picli3/firefly/doc/2026-10-24_06-07.jpg

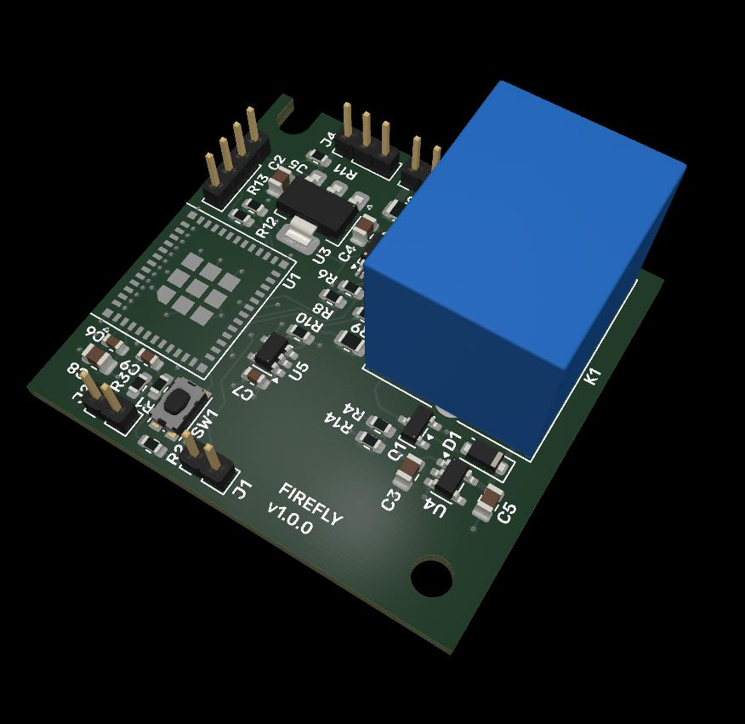
doc/2026-10-24_06-07.jpg
