picli3/firefly/emergency-light-pcb/docs/2026-11-10_10-52.jpg

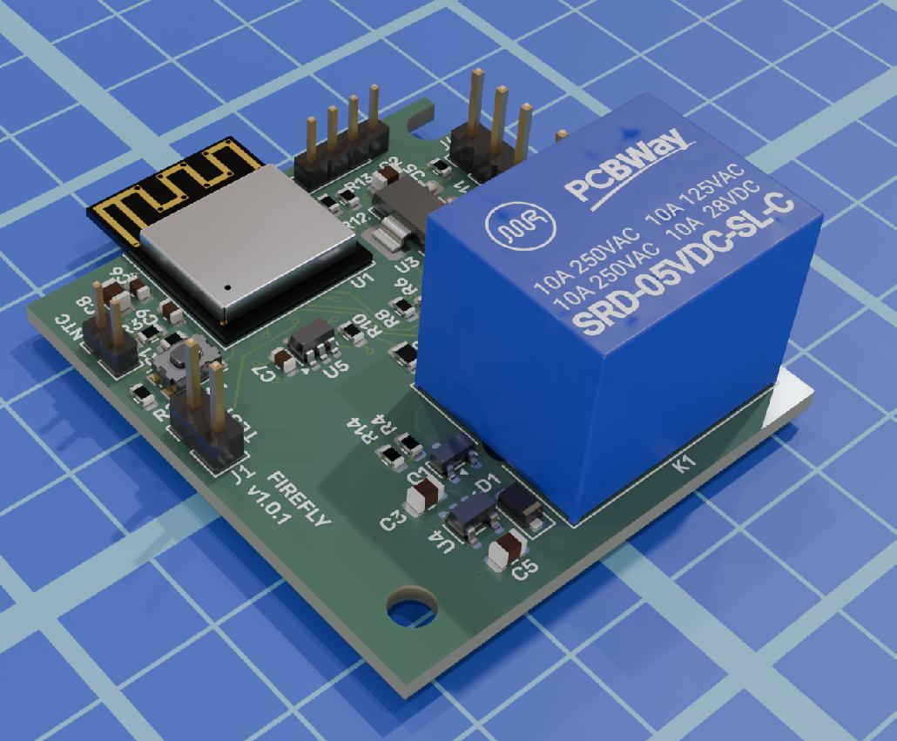
emergency-light-pcb/docs/2026-11-10_10-52.jpg
