picli3/firefly/emergency-light-pcb/docs/2026-11-10_10-54.jpg

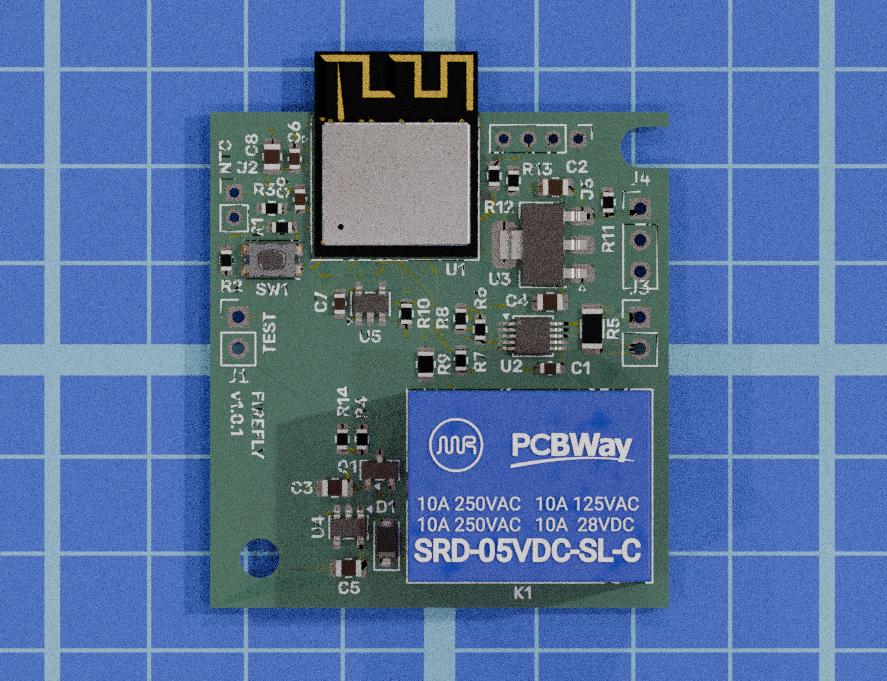
emergency-light-pcb/docs/2026-11-10_10-54.jpg
