picli3/firefly/emergency-light-pcb/docs/2026-11-10_11-06.jpg

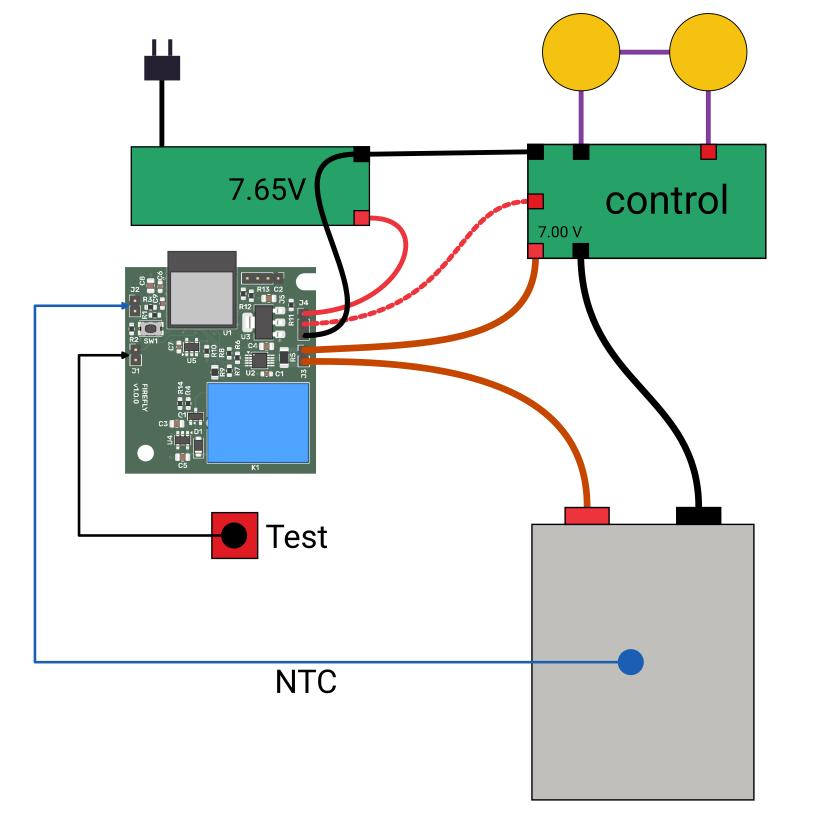
emergency-light-pcb/docs/2026-11-10_11-06.jpg
