picli3/firefly/emergency-light-pcb/docs/photo_2026-11-10_10-07-28.jpg

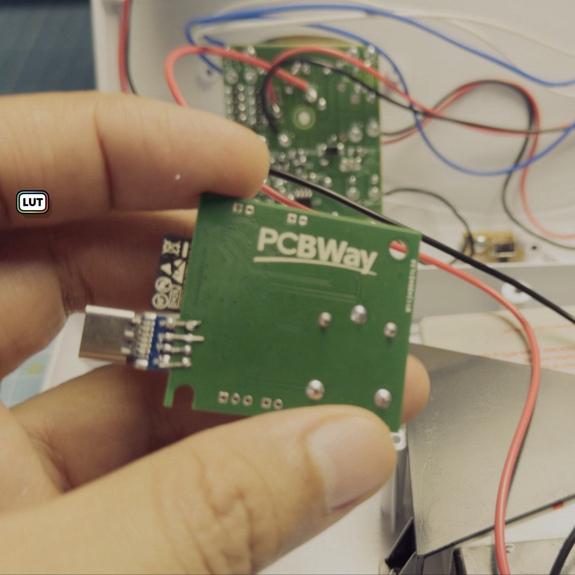
emergency-light-pcb/docs/photo_2026-11-10_10-07-28.jpg
