picli3/firefly/emergency-light-pcb/docs/RELE.png

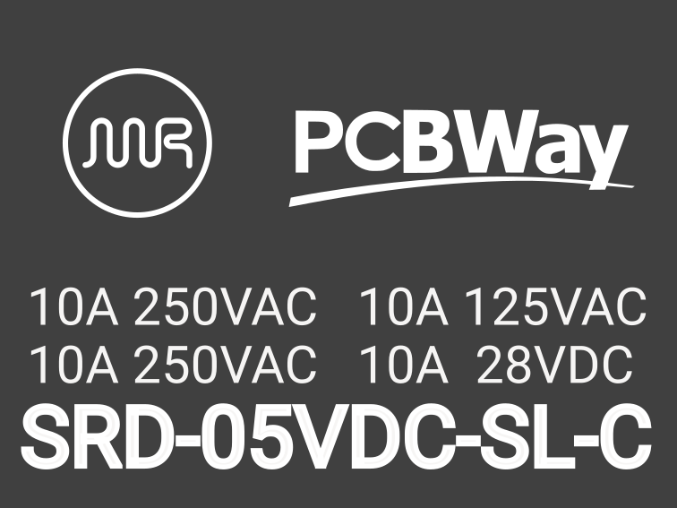
emergency-light-pcb/docs/RELE.png
