picli3/firefly/firmware/h2-emergency-light/img/esp32-h2-supermini.jpg

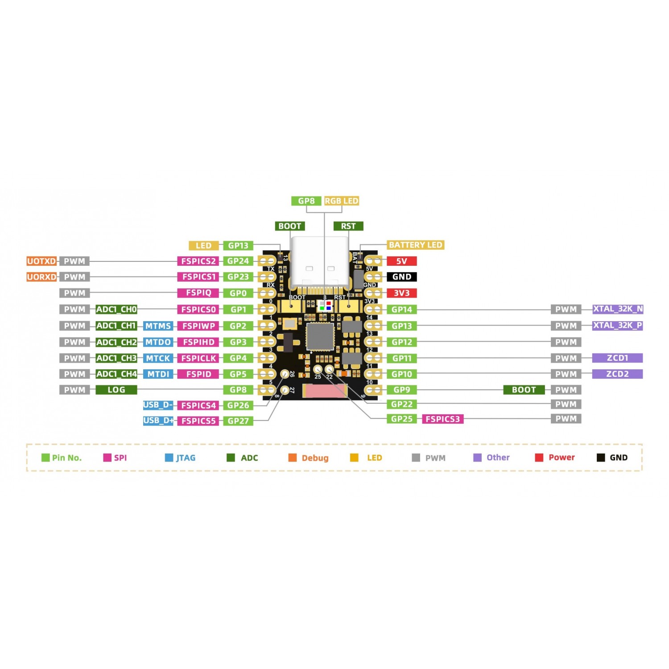
firmware/h2-emergency-light/img/esp32-h2-supermini.jpg
