picli3/firefly/mechanical/emergency-light-pcb.FCStd

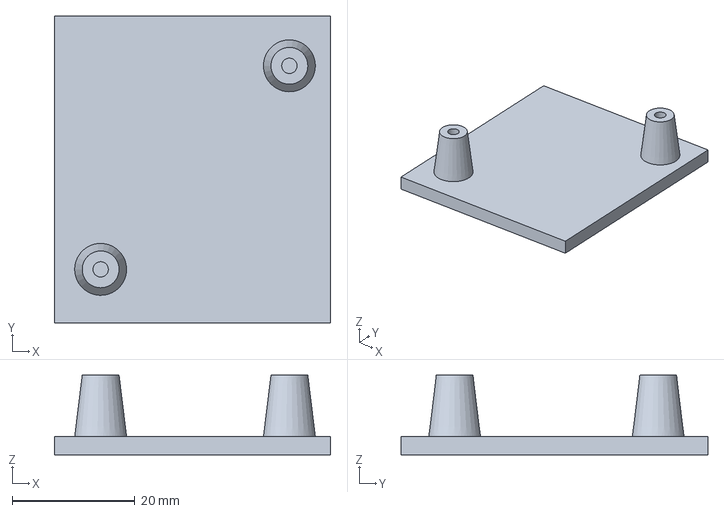
[picture p13: CAD file, 2026-11-10]
mechanical/emergency-light-pcb.FCStd
45.0 x 50.0 x 13.0 mm
