picli3/firefly/emergency-light-pcb/emergency-light-pcb.kicad_pcb

## KiCad design emergency-light-pcb/emergency-light-pcb.kicad_pcb (2026-11-10)

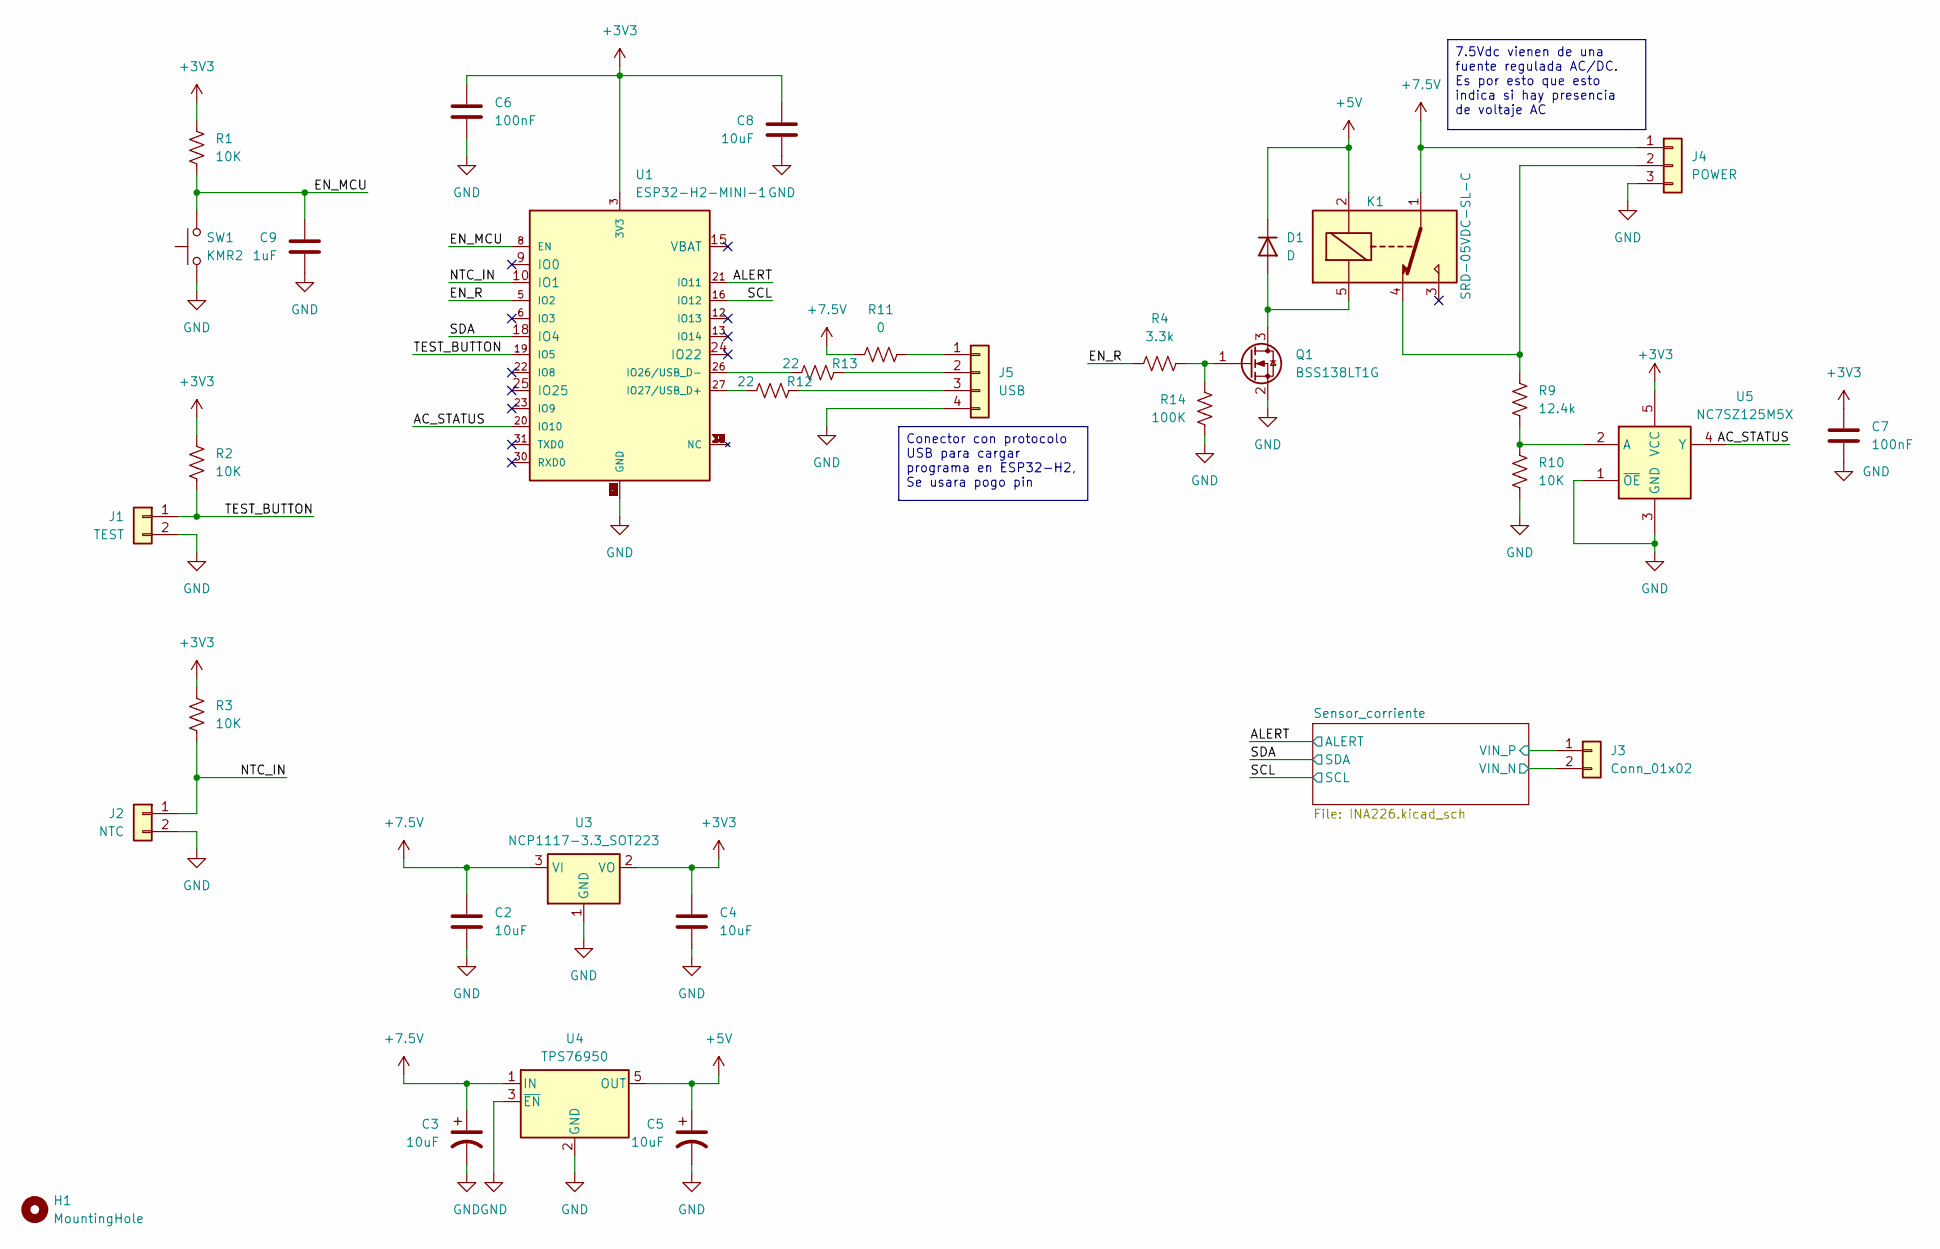
[picture p14: schematic emergency-light-pcb.kicad_sch, ${TITLE}]

Parts:
C2, C3, C4, C5, C8: 10uF; C_0805_2012Metric; Part # CL21A106KAYNNNE; LCSC C15850
C6, C7: 100nF; C_0603_1608Metric; Part # CC0603KRX7R9BB104; LCSC C14663
C9: 1uF; C_0603_1608Metric; Part # CC0603KRX5R8BB105; LCSC C14664
D1: D; D_SOD-123F; Part # 1N5819HW-7-F; LCSC C82544
H1: MountingHole; MountingHole_3.2mm_M3
J1: TEST; PinHeader_1x02_P2.54mm_Vertical; Part # HC-PA-2A; LCSC C2845858
J2: NTC; PinHeader_1x02_P2.00mm_Vertical; Part # HC-PA-2A; LCSC C2845858
J3: Conn_01x02; PinHeader_1x02_P2.54mm_Vertical; Part # HC-PA-2A; LCSC C2845858
J4: POWER; PinHeader_1x03_P2.54mm_Vertical; Part # B3B-PH-K-S(LF)(SN); LCSC C131339
J5: USB; PinHeader_1x04_P2.00mm_Vertical
K1: SRD-05VDC-SL-C; Relay_SPDT_SANYOU_SRD_Series_Form_C; Part # SRD-05VDC-SL-C; LCSC C35449
Q1: BSS138LT1G; SOT-23; Part # BSS138LT1G; LCSC C82045
R1, R2, R3, R10: 10K; R_0603_1608Metric; Part # RC0603FR-0710KL; LCSC C98220
R4: 3.3k; R_0603_1608Metric; Part # RC0603FR-073K3L; LCSC C108078
R9: 12.4k; R_0805_2012Metric; Part # RMC080512.4K1%N; LCSC C325850
R11: 0; R_0603_1608Metric; Part # 0603WAF0000T5E; LCSC C21189
R12, R13: 22; R_0603_1608Metric; Part # 0603WAF220JT5E; LCSC C23345
R14: 100K; R_0603_1608Metric; Part # RC0603FR-07100KL; LCSC C14675
SW1: KMR2; SW_Push_1P1T_NO_CK_KMR2; Part # KMR223GLFG; LCSC C221678
U1: ESP32-H2-MINI-1; ESP32-C6-MINI-1; Part # ESP32-H2-MINI-1-N4; LCSC C18203134
U3: NCP1117-3.3_SOT223; SOT-223-3_TabPin2; Part # NCP1117ST33T3G; LCSC C26537
U4: TPS76950; SOT-23-5; Part # TPS76950DBVR; LCSC C2842394
U5: NC7SZ125M5X; SOT-23-5; Part # NC7SZ125M5X; LCSC C7420

Connections:
+3V3: C4.1, C6.1, C7.1, C8.1, R1.2, R2.2, R3.2, U1.3 (3V3), U3.2 (VO), U5.5 (VCC); also elsewhere on the board
+5V: C5.1, D1.1 (K), K1.2, U4.5 (OUT)
+7.5V: C2.1, C3.1, J4.1, K1.1, R11.1, U3.3 (VI), U4.1 (IN)
/AC_STATUS: U1.20 (IO10), U5.4 (Y)
/ALERT: U1.21 (IO11); also elsewhere on the board
/EN_MCU: C9.1, R1.1, SW1.2, U1.8 (EN)
/EN_R: R4.1, U1.5 (IO2)
/NTC_IN: J2.1, R3.1, U1.10 (IO1)
/SCL: U1.16 (IO12); also elsewhere on the board
/SDA: U1.18 (IO4); also elsewhere on the board
/Sensor_corriente/VIN_N: J3.2; also elsewhere on the board
/Sensor_corriente/VIN_P: J3.1; also elsewhere on the board
/TEST_BUTTON: J1.1, R2.1, U1.19 (IO5)
GND: C2.2, C3.2, C4.2, C5.2, C6.2, C7.2, C8.2, C9.2, J1.2, J2.2, J4.3, J5.4, Q1.2 (S), R10.1, R14.2, SW1.1, U1.1 (GND), U1.2 (GND), U1.11 (GND), U1.14 (GND), U1.36 (GND), U1.37 (GND), U1.38 (GND), U1.39 (GND), U1.40 (GND), U1.41 (GND), U1.42 (GND), U1.43 (GND), U1.44 (GND), U1.45 (GND), U1.46 (GND), U1.47 (GND), U1.48 (GND), U1.49 (GND), U1.50 (GND), U1.51 (GND), U1.52 (GND), U1.53 (GND), U3.1 (GND), U4.2 (GND), U4.3 (~EN), U5.1 (~OE), U5.3 (GND); also elsewhere on the board
unnamed: D1.2 (A), K1.5, Q1.3 (D)
unnamed: J4.2, K1.4, R9.2
unnamed: J5.1, R11.2
unnamed: J5.2, R13.2
unnamed: J5.3, R12.2
unnamed: Q1.1 (G), R4.2, R14.1
unnamed: R13.1, U1.26 (IO26/USB_D-)
unnamed: R12.1, U1.27 (IO27/USB_D+)
unnamed: R9.1, R10.2, U5.2 (A)

Notes on the sheet:
Conector con protocolo USB para cargar programa en ESP32-H2, Se usara pogo pin
7.5Vdc vienen de una fuente regulada AC/DC. Es por esto que esto indica si hay presencia de voltaje AC

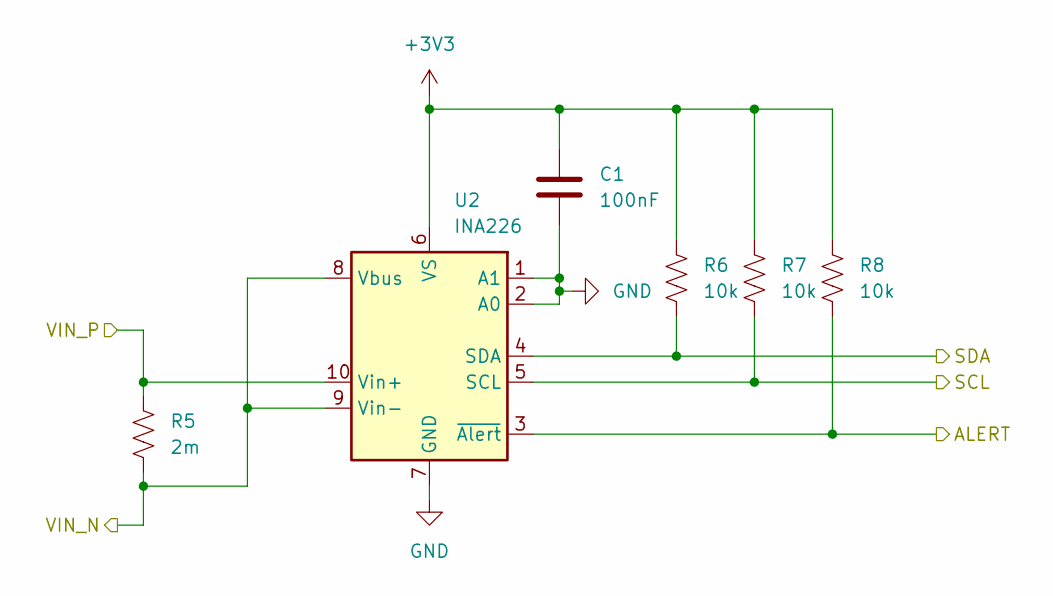
[picture p15: schematic INA226.kicad_sch, ${TITLE}]

Parts:
C1: 100nF; C_0603_1608Metric; Part # CC0603KRX7R9BB104; LCSC C14663
R5: 2m; R_1206_3216Metric; Part # PMR18EZPFV2L00; LCSC C92124
R6, R7, R8: 10k; R_0603_1608Metric; Part # RC0603FR-0710KL; LCSC C98220
U2: INA226; TSSOP-10_3x3mm_P0.5mm; Part # INA226AIDGSR; LCSC C49851

Connections:
+3V3: C1.1, R6.1, R7.1, R8.1, U2.6 (VS); also elsewhere on the board
/ALERT: R8.2, U2.3 (~Alert); also elsewhere on the board
/SCL: R7.2, U2.5 (SCL); also elsewhere on the board
/SDA: R6.2, U2.4 (SDA); also elsewhere on the board
/Sensor_corriente/VIN_N: R5.2, U2.8 (Vbus), U2.9 (Vin-); also elsewhere on the board
/Sensor_corriente/VIN_P: R5.1, U2.10 (Vin+); also elsewhere on the board
GND: C1.2, U2.1 (A1), U2.2 (A0), U2.7 (GND); also elsewhere on the board

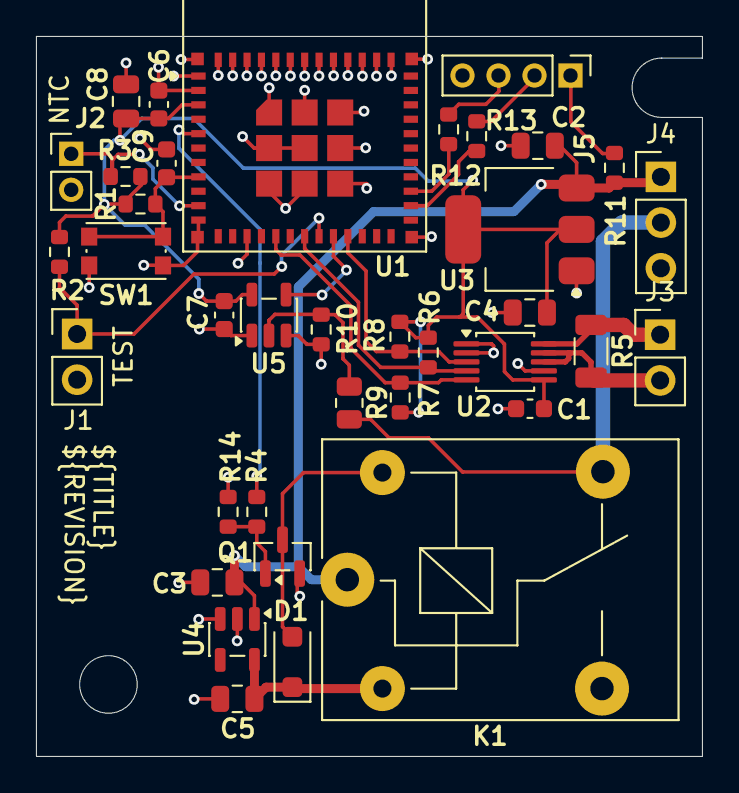
[picture p16: board emergency-light-pcb.kicad_pcb from above]

Board: 2 copper layers, 37.0 x 40.0 mm, 38 parts (0 on the bottom side), 23 nets.
