picli3/firefly/emergency-light-gateway-pcb/emergency-light-gateway-pcb.kicad_pcb

## KiCad design emergency-light-gateway-pcb/emergency-light-gateway-pcb.kicad_pcb (2026-11-10)

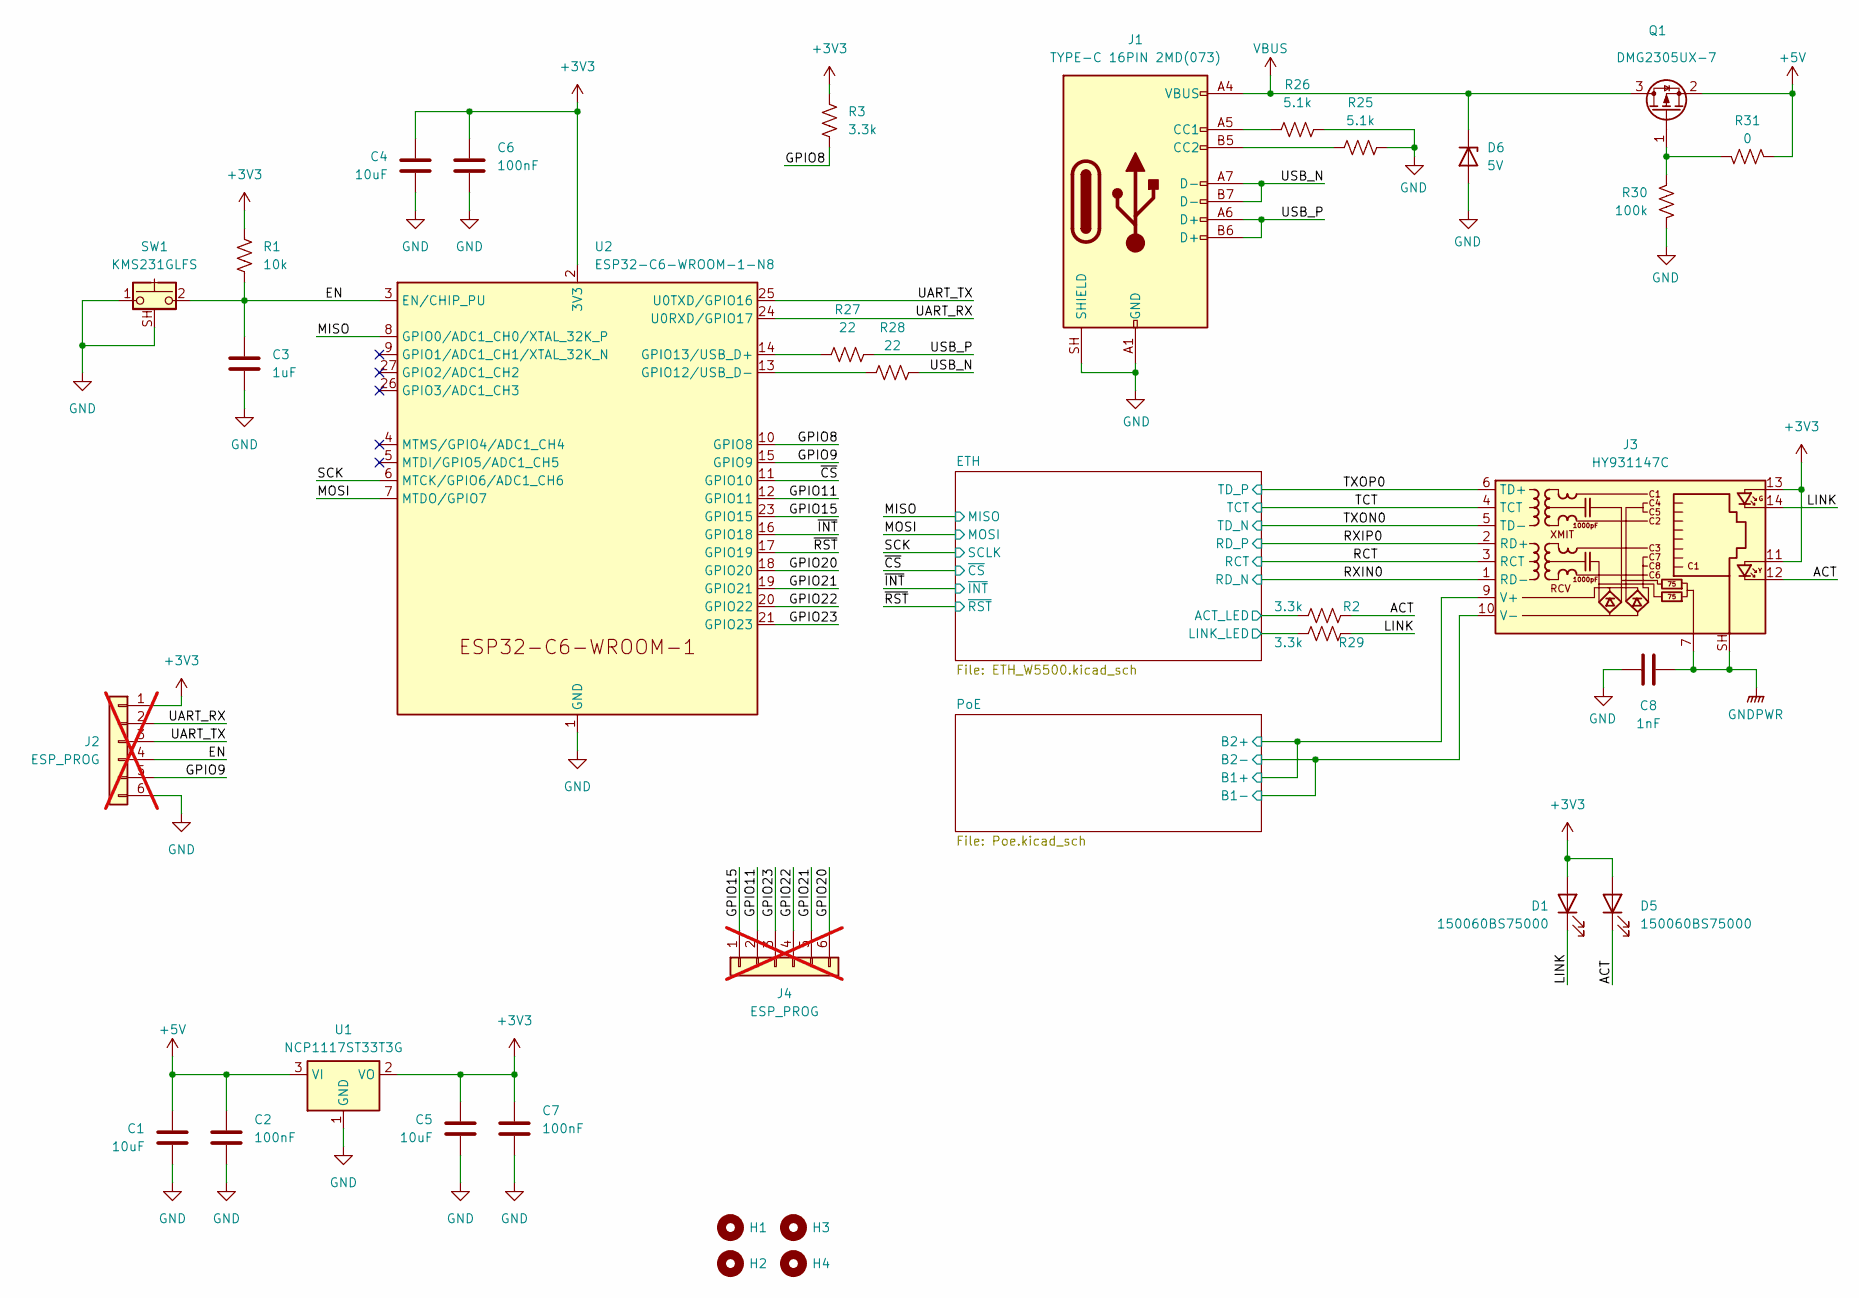
[picture p17: schematic emergency-light-gateway-pcb.kicad_sch, ${TITLE}]

Parts:
C1, C4, C5: 10uF; C_0805_2012Metric; MPN_1 CL21A106KAYNNNE
C2, C6, C7: 100nF; C_0603_1608Metric; MPN_1 CC0603KRX7R9BB104
C3: 1uF; C_0805_2012Metric; Rated Voltage -V; Tolerance ±10%%; MPN_1 CL21B105KBFNNNE
C8: 1nF; C_1206_3216Metric; MPN_1 1206B102K202NT
D1, D5: 150060BS75000; LED_0603_1608Metric
D6: 5V; D_SOD-123F; Forward Voltage -V; Rated Voltage -V; MPN_1 SMF5.0A
H1, H2, H3, H4: MountingHole; MountingHole_3.2mm_M3_ISO14580
J1: TYPE-C 16PIN 2MD(073); USB_C_Receptacle_GCT_USB4105-xx-A_16P_TopMnt_Horizontal; MPN_1 TYPE-C 16PIN 2MD(073)
J2: ESP_PROG; PinHeader_1x06_P2.00mm_Vertical; not fitted
J3: HY931147C; RJ45_HANRUN_HY931147C_Horizontal; MPN_1 HY931147C
J4: ESP_PROG; PinHeader_1x06_P2.54mm_Vertical; not fitted
Q1: DMG2305UX-7; SOT-23; Rated Voltage -V; MPN_1 DMG2305UX-7
R1: 10k; R_0603_1608Metric; Tolerance ±1%%; MPN_1 RC0603FR-0710KL
R2, R3, R29: 3.3k; R_0603_1608Metric; Tolerance ±1%%; MPN_1 RC0603FR-073K3L
R25, R26: 5.1k; R_0603_1608Metric; Tolerance ±1%%; MPN_1 0603WAF5101T5E
R27, R28: 22; R_0603_1608Metric; Tolerance ±1%%; MPN_1 0603WAF220JT5E
R30: 100k; R_0603_1608Metric; Tolerance ±1%%; MPN_1 RC0603FR-07100KL
R31: 0; R_0603_1608Metric; Tolerance ±1%%; MPN_1 0603WAF0000T5E
SW1: KMS231GLFS; SW_SPST_CK_KMS2xxGP; MPN_1 KMS231GLFS
U1: NCP1117ST33T3G; SOT-223-3_TabPin2; MPN_1 NCP1117ST33T3G
U2: ESP32-C6-WROOM-1-N8; ESP32-C6-WROOM-1; MPN_1 ESP32-C6-WROOM-1-N8

Connections:
+3V3: C4.1, C5.1, C6.1, C7.1, D1.2 (A), D5.2 (A), J2.1, J3.11, J3.13, R1.1, R3.1, U1.2 (VO), U2.2 (3V3); also elsewhere on the board
+5V: C1.1, C2.1, Q1.2 (S), R31.2, U1.3 (VI); also elsewhere on the board
/ACT: D5.1 (K), J3.12, R2.2
/EN: C3.1, J2.4, R1.2, SW1.2, U2.3 (EN/CHIP_PU)
/ETH/ACT_LED: R2.1; also elsewhere on the board
/ETH/LINK_LED: R29.1; also elsewhere on the board
/GPIO8: R3.2, U2.10 (GPIO8)
/GPIO9: J2.5, U2.15 (GPIO9)
/GPIO11: J4.2, U2.12 (GPIO11)
/GPIO15: J4.1, U2.23 (GPIO15)
/GPIO20: J4.6, U2.18 (GPIO20)
/GPIO21: J4.5, U2.19 (GPIO21)
/GPIO22: J4.4, U2.20 (GPIO22)
/GPIO23: J4.3, U2.21 (GPIO23)
/LINK: D1.1 (K), J3.14, R29.2
/MISO: U2.8 (GPIO0/ADC1_CH0/XTAL_32K_P); also elsewhere on the board
/MOSI: U2.7 (MTDO/GPIO7); also elsewhere on the board
/PoE/B1+: J3.9 (V+); also elsewhere on the board
/PoE/B1-: J3.10 (V-); also elsewhere on the board
/RCT: J3.3 (RCT); also elsewhere on the board
/RXIN0: J3.1 (RD-); also elsewhere on the board
/RXIP0: J3.2 (RD+); also elsewhere on the board
/SCK: U2.6 (MTCK/GPIO6/ADC1_CH6); also elsewhere on the board
/TCT: J3.4 (TCT); also elsewhere on the board
/TXON0: J3.5 (TD-); also elsewhere on the board
/TXOP0: J3.6 (TD+); also elsewhere on the board
/UART_RX: J2.2, U2.24 (U0RXD/GPIO17)
/UART_TX: J2.3, U2.25 (U0TXD/GPIO16)
/USB_N: J1.A7 (D-), J1.B7 (D-), R28.2
/USB_P: J1.A6 (D+), J1.B6 (D+), R27.2
/~CS: U2.11 (GPIO10); also elsewhere on the board
/~INT: U2.16 (GPIO18); also elsewhere on the board
/~RST: U2.17 (GPIO19); also elsewhere on the board
GND: C1.2, C2.2, C3.2, C4.2, C5.2, C6.2, C7.2, C8.1, D6.2 (A), J1.A1 (GND), J1.A12 (GND), J1.B1 (GND), J1.B12 (GND), J1.SH (SHIELD), J2.6, R25.2, R26.2, R30.1, SW1.1, SW1.SH (B), U1.1 (GND), U2.1 (GND), U2.28 (GND), U2.29 (GND); also elsewhere on the board
GNDPWR: C8.2, J3.7, J3.SH
unnamed: J1.A5 (CC1), R26.1
unnamed: J1.B5 (CC2), R25.1
unnamed: Q1.1 (G), R30.2, R31.1
unnamed: R28.1, U2.13 (GPIO12/USB_D-)
unnamed: R27.1, U2.14 (GPIO13/USB_D+)
VBUS: D6.1 (K), J1.A4 (VBUS), J1.A9 (VBUS), J1.B4 (VBUS), J1.B9 (VBUS), Q1.3 (D)

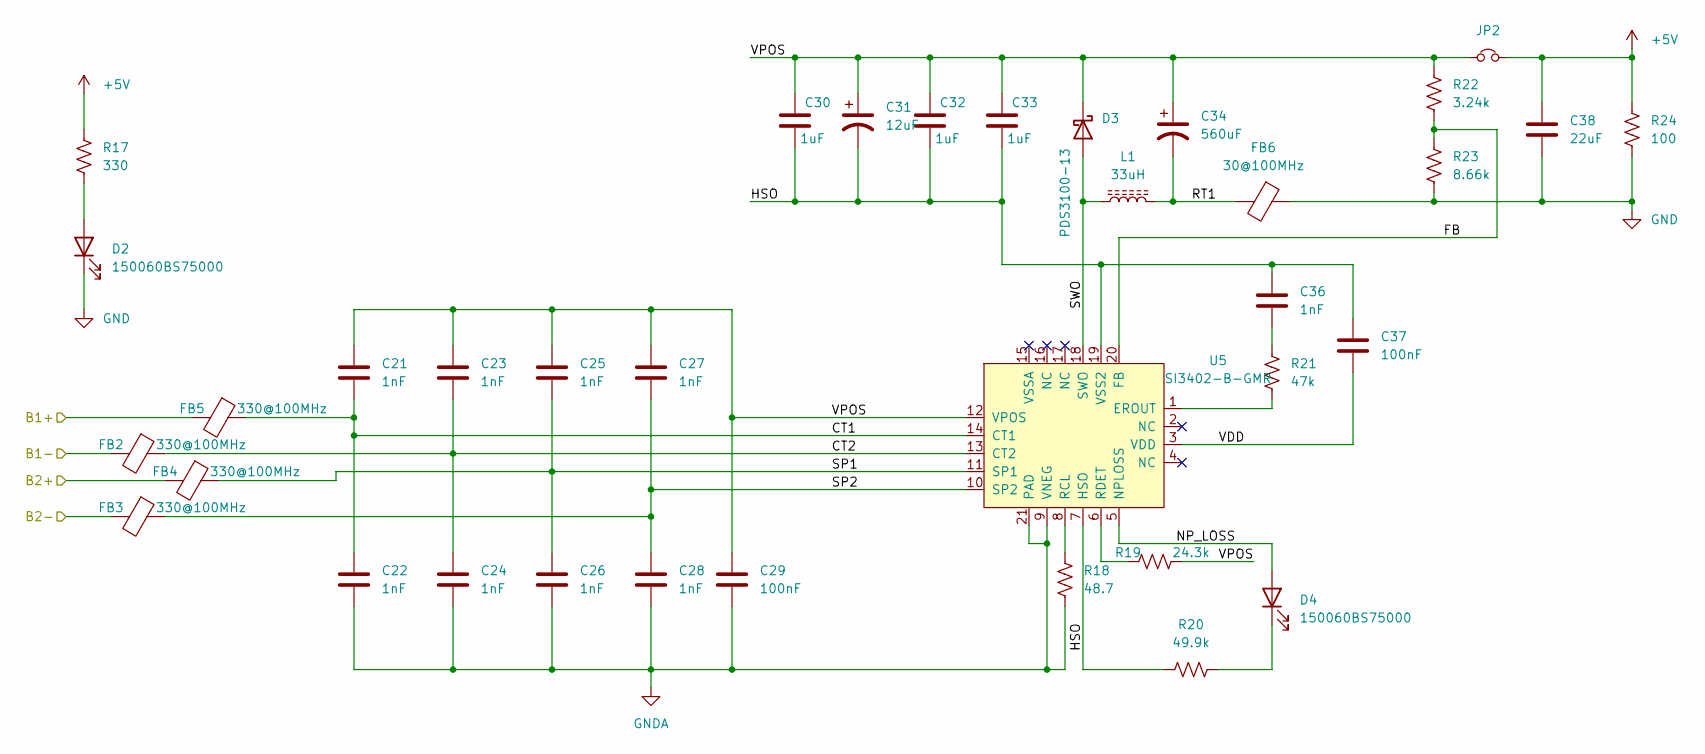
[picture p18: schematic Poe.kicad_sch, ${TITLE}]

Parts:
C21, C22, C23, C24, C25, C26, C27, C28: 1nF; C_0603_1608Metric; Rated Voltage -V; Tolerance ±10%%; MPN_1 CL10B102KC8NNNC
C29: 100nF; C_0805_2012Metric; Rated Voltage -V; Tolerance ±10%%; MPN_1 FTC0805X7R101-104KNE
C30, C32, C33: 1uF; C_1210_3225Metric; Rated Voltage -V; Tolerance ±10%%; Mfg Part # CL31B105KCHNNNE
C31: 12uF; CP_Radial_D5.0mm_P2.00mm; Rated Voltage -V; Tolerance ±20%%; MPN_1 LKMB1102A120MF
C34: 560uF; CP_Radial_D6.3mm_P2.50mm; Rated Voltage 6.3VV; Tolerance ±20%%; Mfg Part # T495D477M006ATE045
C36: 1nF; C_0603_1608Metric; Mfg Part # 06035C102KAT2A
C37: 100nF; C_0603_1608Metric; Mfg Part # CC0603ZRY5V9BB104
C38: 22uF; C_0805_2012Metric; Mfg Part # GRM21BR61E226ME44L
D2, D4: 150060BS75000; LED_0603_1608Metric
D3: PDS3100-13; D_PowerDI-5; Forward Voltage -V; Rated Voltage 100VV; MPN_1 PDS3100-13
FB2, FB3, FB4, FB5: 330@100MHz; L_0805_2012Metric; Tolerance ±25%%; Mfg Part # BLM21SP331SH1D
FB6: 30@100MHz; L_0805_2012Metric; Tolerance ±25%%; Mfg Part # MPZ1608S300ATAH0
JP2: Jumper_NC_Small; SolderJumper-2_P1.3mm_Bridged2Bar_RoundedPad1.0x1.5mm; Mfg Part # DNP
L1: 33uH; L_SXN_SMDRI127; Tolerance ±20%%; MPN_1 SMDRI127-330MT
R17: 330; R_0603_1608Metric; Tolerance ±1%%; Mfg Part # RC0603FR-07330RL
R18: 48.7; R_0603_1608Metric; Tolerance -%
R19: 24.3k; R_0603_1608Metric; Tolerance -%; Mfg Part # RC0603FR-0724K3L
R20: 49.9k; R_0603_1608Metric; Tolerance -%; Mfg Part # RC0603FR-0749K9L
R21: 47k; R_0603_1608Metric; Tolerance -%; Mfg Part # RC0603JR-0747KL
R22: 3.24k; R_0603_1608Metric; Tolerance -%; Mfg Part # RC0603FR-073K24L
R23: 8.66k; R_0603_1608Metric; Tolerance ±1%%; Mfg Part # RC0603FR-078K66L
R24: 100; R_1210_3225Metric; Tolerance ±1%%; Mfg Part # RC0603JR-07100RL
U5: SI3402-B-GMR; SI3402-X; Rated Voltage 37V~57VV; Mfg Part # SI3402-B-GMR; LCSC C510771

Connections:
+5V: C38.1, JP2.2, R17.1, R24.1; also elsewhere on the board
/PoE/B1+: FB4.2, FB5.2; also elsewhere on the board
/PoE/B1-: FB2.2, FB3.2; also elsewhere on the board
/PoE/CT1: C21.2, C22.1, FB5.1, U5.14 (CT1)
/PoE/CT2: C23.2, C24.1, FB2.1, U5.13 (CT2)
/PoE/FB: R22.2, R23.1, U5.20 (FB)
/PoE/HSO: C30.2, C31.2, C32.2, C33.2, C36.1, C37.1, R20.1, U5.7 (HSO), U5.19 (VSS2)
/PoE/NP_LOSS: D4.2 (A), U5.5 (NPLOSS)
/PoE/RT1: C34.2, FB6.2, L1.2
/PoE/SP1: C25.2, C26.1, FB4.1, U5.11 (SP1)
/PoE/SP2: C27.2, C28.1, FB3.1, U5.10 (SP2)
/PoE/SWO: D3.2 (A), L1.1, U5.18 (SWO)
/PoE/VDD: C37.2, U5.3 (VDD)
/PoE/VPOS: C21.1, C23.1, C25.1, C27.1, C29.1, C30.1, C31.1, C32.1, C33.1, C34.1, D3.1 (K), JP2.1, R19.1, R22.1, U5.12 (VPOS)
GND: C38.2, D2.1 (K), FB6.1, R23.2, R24.2; also elsewhere on the board
GNDA: C22.2, C24.2, C26.2, C28.2, C29.2, R18.2, U5.9 (VNEG), U5.21 (PAD)
unnamed: C36.2, R21.1
unnamed: D2.2 (A), R17.2
unnamed: D4.1 (K), R20.2
unnamed: R21.2, U5.1 (EROUT)
unnamed: R18.1, U5.8 (RCL)
unnamed: R19.2, U5.6 (RDET)

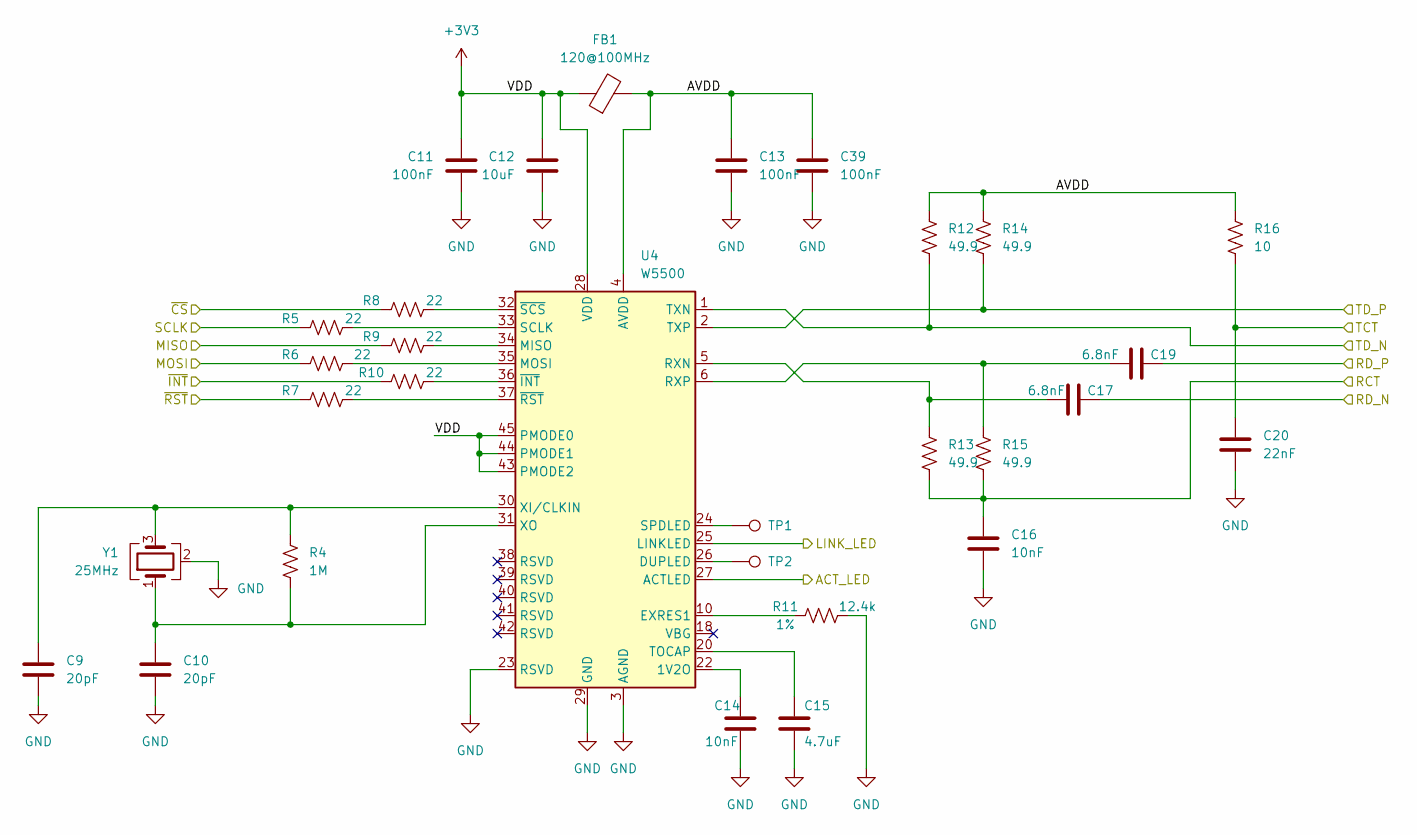
[picture p19: schematic ETH_W5500.kicad_sch, ${TITLE}]

Parts:
C9, C10: 20pF; C_0603_1608Metric; Rated Voltage -V; Tolerance ±5%%; MPN_1 CC0603JRNPO9BN200
C11, C13, C39: 100nF; C_0603_1608Metric; Part # CL10B104KO8NNNC; LCSC C66501
C12: 10uF; C_0805_2012Metric; Part # CL21A106KPFNNNE; LCSC C15850
C14, C16: 10nF; C_0603_1608Metric; Part # CC0603KRX7R7BB103; LCSC C519406
C15: 4.7uF; C_0603_1608Metric; MPN_1 CL10A475KP8NNNC
C17, C19: 6.8nF; C_0603_1608Metric; Rated Voltage -V; Tolerance ±10%%; Part # CC0603KRX7R9BB682; LCSC C107097
C20: 22nF; C_0603_1608Metric; Rated Voltage -V; Tolerance ±10%%; Part # CC0603KRX7R9BB223; LCSC C106222
FB1: 120@100MHz; L_0603_1608Metric; Tolerance ±25%%; Part # CBM160808U121T; LCSC C62708
R4: 1M; R_0603_1608Metric; Tolerance ±1%%; MPN_1 RC0603FR-071ML
R5, R6, R7, R8, R9, R10: 22; R_0603_1608Metric; Tolerance ±1%%; MPN_1 0603WAF220JT5E
R11: 12.4k; R_0805_2012Metric; Tolerance ±1%%; Part # RMC080512.4K1%N; LCSC C325850
R12, R13, R14, R15: 49.9; R_0603_1608Metric; Tolerance ±1%%; Part # WR06X49R9FTL; LCSC C163926
R16: 10; R_0603_1608Metric; Tolerance ±1%%; Part # 0603WAF100JT5E; LCSC C22859
TP1, TP2: TestPoint; TestPoint_Pad_1.0x1.0mm
U4: W5500; LQFP-48_7x7mm_P0.5mm; Rated Voltage 3.3VV; MPN_1 W5500
Y1: 25MHz; Crystal_SMD_SeikoEpson_FA238V-4Pin_3.2x2.5mm; Frequency Tolerance -ppm; Rated Voltage -V; MPN_1 XTM32025000JT00351001

Connections:
+3V3: C11.1, C12.1, FB1.1, U4.28 (VDD), U4.43 (PMODE2), U4.44 (PMODE1), U4.45 (PMODE0); also elsewhere on the board
/ETH/ACT_LED: U4.27 (ACTLED); also elsewhere on the board
/ETH/AVDD: C13.1, C39.1, FB1.2, R12.2, R14.2, R16.2, U4.4 (AVDD), U4.8 (AVDD), U4.11 (AVDD), U4.15 (AVDD), U4.17 (AVDD), U4.21 (AVDD)
/ETH/LINK_LED: U4.25 (LINKLED); also elsewhere on the board
/MISO: R9.1; also elsewhere on the board
/MOSI: R6.1; also elsewhere on the board
/RCT: C16.1, R13.1, R15.1; also elsewhere on the board
/RXIN0: C17.2; also elsewhere on the board
/RXIP0: C19.2; also elsewhere on the board
/SCK: R5.1; also elsewhere on the board
/TCT: C20.1, R16.1; also elsewhere on the board
/TXON0: R12.1, U4.1 (TXN); also elsewhere on the board
/TXOP0: R14.1, U4.2 (TXP); also elsewhere on the board
/~CS: R8.1; also elsewhere on the board
/~INT: R10.1; also elsewhere on the board
/~RST: R7.1; also elsewhere on the board
GND: C9.2, C10.2, C11.2, C12.2, C13.2, C14.2, C15.2, C16.2, C20.2, C39.2, R11.2, U4.3 (AGND), U4.9 (AGND), U4.14 (AGND), U4.16 (AGND), U4.19 (AGND), U4.23 (RSVD), U4.29 (GND), U4.48 (AGND), Y1.2 (G), Y1.4 (G); also elsewhere on the board
unnamed: C14.1, U4.22 (1V2O)
unnamed: TP2.1 (1_1), U4.26 (DUPLED)
unnamed: R11.1, U4.10 (EXRES1)
unnamed: R9.2, U4.34 (MISO)
unnamed: R6.2, U4.35 (MOSI)
unnamed: C17.1, R13.2, U4.5 (RXN)
unnamed: C19.1, R15.2, U4.6 (RXP)
unnamed: R5.2, U4.33 (SCLK)
unnamed: TP1.1 (1_1), U4.24 (SPDLED)
unnamed: C15.1, U4.20 (TOCAP)
unnamed: C9.1, R4.2, U4.30 (XI/CLKIN), Y1.3
unnamed: C10.1, R4.1, U4.31 (XO), Y1.1
unnamed: R10.2, U4.36 (~INT)
unnamed: R7.2, U4.37 (~RST)
unnamed: R8.2, U4.32 (~SCS)

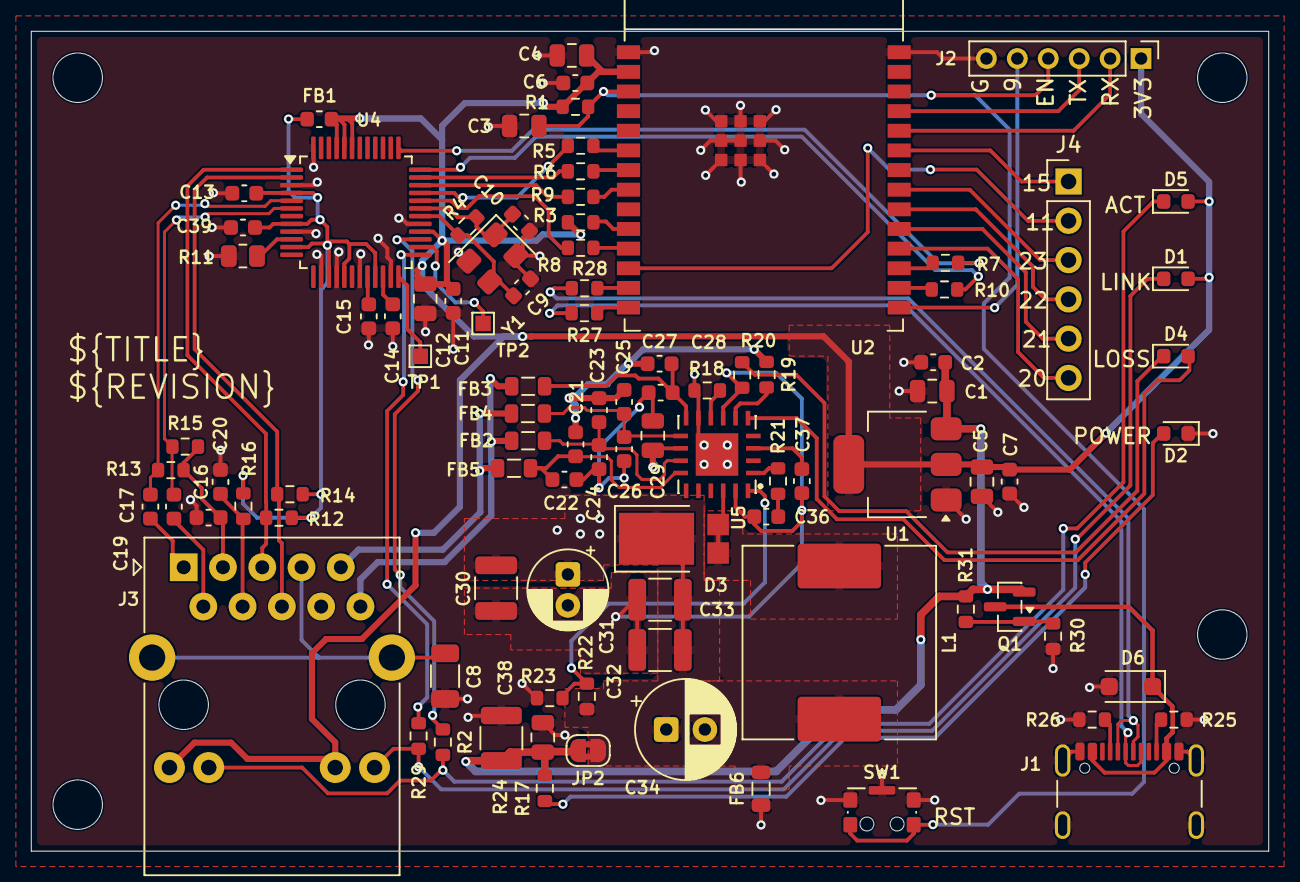
[picture p20: board emergency-light-gateway-pcb.kicad_pcb from above]

Board: 2 copper layers, 80.0 x 53.0 mm, 99 parts (0 on the bottom side), 75 nets.
