picli3/firefly/firmware/h2-emergency-light/main/zigbee_node.h

#pragma once

#include <stdbool.h>

#include "emergency_protocol.h"
#include "esp_err.h"

esp_err_t zigbee_node_init(void);
esp_err_t zigbee_node_start(void);
bool zigbee_node_is_joined(void);
esp_err_t zigbee_node_send_telemetry(const emergency_telemetry_t *sample);
esp_err_t zigbee_node_send_test_report(const battery_test_report_t *report);
