picli3/firefly/(commit log)

2026-08-26 Iniciando repo
    [emergency-light-pcb.kicad_pcb, emergency-light-pcb.kicad_sch, partitions.csv]
2026-09-07 antes de que la IA meta mano
    [INA226.kicad_sch, emergency-light-pcb.kicad_pcb, emergency-light-pcb.kicad_sch]
2026-09-08 completando diseño de PCB
    [INA226.kicad_sch, emergency-light-pcb.kicad_pcb, emergency-light-pcb.kicad_sch]
2026-09-11 agregando logo PCBway
    [emergency-light-pcb.kicad_pcb]
2026-11-05 completando parcialmente la PCB del gateway
    [ETH_W5500.kicad_sch, Poe.kicad_sch, emergency-light-gateway-pcb.kicad_pcb, emergency-light-gateway-pcb.kicad_sch]
2026-11-09 actualiza alcance del proyecto de lampara IoT
2026-11-10 borranco archivos imnecesarios
    [partitions.csv]
2026-11-10 actualizando cambios del gateway ESP32-C6
    [partitions.csv]
2026-11-10 actualizando firware del ESP32-H2
2026-11-10 agregando archivos adicionales para el firmware
2026-11-10 agregando la PCB del ESP32-C6-gateway
    [ETH_W5500.kicad_sch, Poe.kicad_sch, emergency-light-gateway-pcb.kicad_pcb, emergency-light-gateway-pcb.kicad_sch]
2026-11-10 agregando PCB de monitor lampara
    [emergency-light-pcb.kicad_pcb, emergency-light-pcb.kicad_sch]
2026-11-10 agregando archivos adicionales
    [emergency-light-pcb.FCStd]
